analogicus/jnw_gr02_sky130a/sim/JNW_VIS_TI/READMELay.md

TB_NCM

### Transient analysis Schematic (tran)

Check transient operation

|**Name**|**Parameter**|**Description**| |**Min**|**Typ**|**Max**| Unit|
|:---|:---|:---|---:|:---:|:---:|:---:| ---:|
|**Referance Voltage**|**vref27** || **Spec**  | **0.90000** | **1.20000** | **1.50000** | **V** |
| | | |<a href='results/tran_Sch_typical.html'>Sch_typ</a>| | 1.20066 |  | |
| | | |<a href='results/tran_Sch_etc.html'>Sch_etc</a>|1.19779 | 1.20082 | 1.20342 | |
| | | |<a href='results/tran_Sch_mc.html'>Sch_3std</a>|1.07695 | 1.20448 | 1.33201 | |
|**Temperature current**|**i\_temp27** || **Spec**  | **3.00000** | **4.00000** | **5.00000** | **uA** |
| | | |<a href='results/tran_Sch_typical.html'>Sch_typ</a>| | 3.98492 |  | |
| | | |<a href='results/tran_Sch_etc.html'>Sch_etc</a>|3.42394 | 3.97680 | 4.64859 | |
| | | |<a href='results/tran_Sch_mc.html'>Sch_3std</a>|3.07677 | 4.00629 | 4.93581 | |

### Transient analysis Layout (tran_lay)

Check transient operation

|**Name**|**Parameter**|**Description**| |**Min**|**Typ**|**Max**| Unit|
|:---|:---|:---|---:|:---:|:---:|:---:| ---:|
|**Referance Voltage**|**vref27** || **Spec**  | **0.90000** | **1.20000** | **1.50000** | **V** |
| | | |<a href='results/tran_Lay_typical.html'>Lay_typ</a>| | 1.19531 |  | |
| | | |<a href='results/tran_Lay_etc.html'>Lay_etc</a>|1.19195 | 1.19546 | 1.19891 | |
| | | |<a href='results/tran_Lay_mc.html'>Lay_3std</a>|0.99423 | 1.20512 | 1.41601 | |
|**Temperature current**|**i\_temp27** || **Spec**  | **3.00000** | **4.00000** | **5.00000** | **uA** |
| | | |<a href='results/tran_Lay_typical.html'>Lay_typ</a>| | 3.83903 |  | |
| | | |<a href='results/tran_Lay_etc.html'>Lay_etc</a>|3.29571 | 3.83206 | 4.48719 | |
| | | |<a href='results/tran_Lay_mc.html'>Lay_3std</a>|<span style='color:red'>**2.52033**</span> | 3.87374 | <span style='color:red'>**5.22715**</span> | |
