analogicus/jnw_gr02_sky130a/sim/JNW_VIS_TI/summary.md

TB_NCM

### Transient analysis (tran)

Check transient operation

|**Name**|**Parameter**|**Description**| |**Min**|**Typ**|**Max**| Unit|
|:---|:---|:---|---:|:---:|:---:|:---:| ---:|
|**Referance Voltage**|**vref27** || **Spec**  | **0.96000** | **1.20000** | **1.44000** | **V** |
| | | |<a href='results/tran_Sch_typical.html'>Sch_typ</a>| | 1.20077 |  | |
| | | |<a href='results/tran_Sch_etc.html'>Sch_etc</a>|1.19409 | 1.20150 | 1.20996 | |
| | | |<a href='results/tran_Sch_mc.html'>Sch_3std</a>|<span style='color:red'>**0.92611**</span> | 1.26353 | <span style='color:red'>**1.60095**</span> | |
|**Temperature current**|**i\_temp27** || **Spec**  | **1.35000** | **1.80000** | **2.25000** | **uA** |
| | | |<a href='results/tran_Sch_typical.html'>Sch_typ</a>| | 1.89620 |  | |
| | | |<a href='results/tran_Sch_etc.html'>Sch_etc</a>|1.66109 | 1.89896 | 2.20755 | |
| | | |<a href='results/tran_Sch_mc.html'>Sch_3std</a>|<span style='color:red'>**0.82957**</span> | 2.11308 | <span style='color:red'>**3.39658**</span> | |
