analogicus/jnw_gr02_sky130a/rtl/syntesized_design/metrics.csv

Metric | Value
design__lint_error__count | 0
design__lint_timing_construct__count | 0
design__lint_warning__count | 0
design__inferred_latch__count | 0
design__instance__count | 97
design__instance__area | 907.12
design__instance_unmapped__count | 0
synthesis__check_error__count | 0
design__max_slew_violation__count__corner:nom_tt_025C_1v80 | 0
design__max_fanout_violation__count__corner:nom_tt_025C_1v80 | 0
design__max_cap_violation__count__corner:nom_tt_025C_1v80 | 0
power__internal__total | 0.000059762245655292645
power__switching__total | 0.000021324993213056587
power__leakage__total | 1.851219955106842E-9
power__total | 0.00008108908514259383
clock__skew__worst_hold__corner:nom_tt_025C_1v80 | -0.2506414036150417
clock__skew__worst_setup__corner:nom_tt_025C_1v80 | 0.25087249654415317
timing__hold__ws__corner:nom_tt_025C_1v80 | 0.328870384677856
timing__setup__ws__corner:nom_tt_025C_1v80 | 22.779059283579723
timing__hold__tns__corner:nom_tt_025C_1v80 | 0.0
timing__setup__tns__corner:nom_tt_025C_1v80 | 0.0
timing__hold__wns__corner:nom_tt_025C_1v80 | 0
timing__setup__wns__corner:nom_tt_025C_1v80 | 0.0
timing__hold_vio__count__corner:nom_tt_025C_1v80 | 0
timing__hold_r2r__ws__corner:nom_tt_025C_1v80 | 0.328870
timing__hold_r2r_vio__count__corner:nom_tt_025C_1v80 | 0
timing__setup_vio__count__corner:nom_tt_025C_1v80 | 0
timing__setup_r2r__ws__corner:nom_tt_025C_1v80 | Infinity
timing__setup_r2r_vio__count__corner:nom_tt_025C_1v80 | 0
design__max_slew_violation__count__corner:nom_ss_100C_1v60 | 0
design__max_fanout_violation__count__corner:nom_ss_100C_1v60 | 0
design__max_cap_violation__count__corner:nom_ss_100C_1v60 | 0
clock__skew__worst_hold__corner:nom_ss_100C_1v60 | -0.2510860201934031
clock__skew__worst_setup__corner:nom_ss_100C_1v60 | 0.2513045676019815
timing__hold__ws__corner:nom_ss_100C_1v60 | 0.865721796531863
timing__setup__ws__corner:nom_ss_100C_1v60 | 21.58372031083137
timing__hold__tns__corner:nom_ss_100C_1v60 | 0.0
timing__setup__tns__corner:nom_ss_100C_1v60 | 0.0
timing__hold__wns__corner:nom_ss_100C_1v60 | 0
timing__setup__wns__corner:nom_ss_100C_1v60 | 0.0
timing__hold_vio__count__corner:nom_ss_100C_1v60 | 0
timing__hold_r2r__ws__corner:nom_ss_100C_1v60 | 0.865722
timing__hold_r2r_vio__count__corner:nom_ss_100C_1v60 | 0
timing__setup_vio__count__corner:nom_ss_100C_1v60 | 0
timing__setup_r2r__ws__corner:nom_ss_100C_1v60 | Infinity
timing__setup_r2r_vio__count__corner:nom_ss_100C_1v60 | 0
design__max_slew_violation__count__corner:nom_ff_n40C_1v95 | 0
design__max_fanout_violation__count__corner:nom_ff_n40C_1v95 | 0
design__max_cap_violation__count__corner:nom_ff_n40C_1v95 | 0
clock__skew__worst_hold__corner:nom_ff_n40C_1v95 | -0.25056052386541033
clock__skew__worst_setup__corner:nom_ff_n40C_1v95 | 0.2507960021755931
timing__hold__ws__corner:nom_ff_n40C_1v95 | 0.11220624746938532
timing__setup__ws__corner:nom_ff_n40C_1v95 | 23.142537430337665
timing__hold__tns__corner:nom_ff_n40C_1v95 | 0.0
timing__setup__tns__corner:nom_ff_n40C_1v95 | 0.0
timing__hold__wns__corner:nom_ff_n40C_1v95 | 0
timing__setup__wns__corner:nom_ff_n40C_1v95 | 0.0
timing__hold_vio__count__corner:nom_ff_n40C_1v95 | 0
timing__hold_r2r__ws__corner:nom_ff_n40C_1v95 | 0.112206
timing__hold_r2r_vio__count__corner:nom_ff_n40C_1v95 | 0
timing__setup_vio__count__corner:nom_ff_n40C_1v95 | 0
timing__setup_r2r__ws__corner:nom_ff_n40C_1v95 | Infinity
timing__setup_r2r_vio__count__corner:nom_ff_n40C_1v95 | 0
design__max_slew_violation__count | 0
design__max_fanout_violation__count | 0
design__max_cap_violation__count | 0
clock__skew__worst_hold | -0.25042901794442424
clock__skew__worst_setup | 0.2505912770440622
timing__hold__ws | 0.1099763922169367
timing__setup__ws | 21.57810524670322
timing__hold__tns | 0.0
timing__setup__tns | 0.0
timing__hold__wns | 0
timing__setup__wns | 0.0
timing__hold_vio__count | 0
timing__hold_r2r__ws | 0.109976
timing__hold_r2r_vio__count | 0
timing__setup_vio__count | 0
timing__setup_r2r__ws | inf
timing__setup_r2r_vio__count | 0
design__die__bbox | 0.0 0.0 33.0 120.0
design__core__bbox | 5.52 10.88 27.14 108.8
design__io | 12
design__die__area | 3960
design__core__area | 2117.03
design__instance__count__stdcell | 97
design__instance__area__stdcell | 907.12
design__instance__count__macros | 0
design__instance__area__macros | 0
design__instance__utilization | 0.428487
design__instance__utilization__stdcell | 0.428487
design__instance__count__class:inverter | 1
design__instance__count__class:sequential_cell | 17
design__instance__count__class:multi_input_combinational_cell | 30
flow__warnings__count | 1
flow__errors__count | 0
design__instance__count__class:fill_cell | 233
design__instance__count__class:tap_cell | 19
design__power_grid_violation__count__net:VGND | 0
design__power_grid_violation__count__net:VPWR | 0
design__power_grid_violation__count | 0
timing__drv__floating__nets | 0
timing__drv__floating__pins | 0
design__instance__displacement__total | 0
design__instance__displacement__mean | 0
design__instance__displacement__max | 0
route__wirelength__estimated | 1065.7
design__violations | 0
design__instance__count__class:timing_repair_buffer | 26
design__instance__count__class:clock_buffer | 4
design__instance__count__setup_buffer | 0
design__instance__count__hold_buffer | 17
antenna__violating__nets | 0
antenna__violating__pins | 0
route__antenna_violation__count | 0
antenna_diodes_count | 0
route__net | 79
route__net__special | 2
route__drc_errors__iter:1 | 3
route__wirelength__iter:1 | 1158
route__drc_errors__iter:2 | 0
route__wirelength__iter:2 | 1160
route__drc_errors | 0
route__wirelength | 1160
route__vias | 460
route__vias__singlecut | 460
route__vias__multicut | 0
design__disconnected_pin__count | 0
design__critical_disconnected_pin__count | 0
route__wirelength__max | 102.48
timing__unannotated_net__count__corner:nom_tt_025C_1v80 | 1
timing__unannotated_net_filtered__count__corner:nom_tt_025C_1v80 | 0
timing__unannotated_net__count__corner:nom_ss_100C_1v60 | 1
timing__unannotated_net_filtered__count__corner:nom_ss_100C_1v60 | 0
timing__unannotated_net__count__corner:nom_ff_n40C_1v95 | 1
timing__unannotated_net_filtered__count__corner:nom_ff_n40C_1v95 | 0
design__max_slew_violation__count__corner:min_tt_025C_1v80 | 0
design__max_fanout_violation__count__corner:min_tt_025C_1v80 | 0
design__max_cap_violation__count__corner:min_tt_025C_1v80 | 0
clock__skew__worst_hold__corner:min_tt_025C_1v80 | -0.25049066307961
clock__skew__worst_setup__corner:min_tt_025C_1v80 | 0.2506497025323855
timing__hold__ws__corner:min_tt_025C_1v80 | 0.32402326183755903
timing__setup__ws__corner:min_tt_025C_1v80 | 22.780624253999495
timing__hold__tns__corner:min_tt_025C_1v80 | 0.0
timing__setup__tns__corner:min_tt_025C_1v80 | 0.0
timing__hold__wns__corner:min_tt_025C_1v80 | 0
timing__setup__wns__corner:min_tt_025C_1v80 | 0.0
timing__hold_vio__count__corner:min_tt_025C_1v80 | 0
timing__hold_r2r__ws__corner:min_tt_025C_1v80 | 0.324023
timing__hold_r2r_vio__count__corner:min_tt_025C_1v80 | 0
timing__setup_vio__count__corner:min_tt_025C_1v80 | 0
timing__setup_r2r__ws__corner:min_tt_025C_1v80 | Infinity
timing__setup_r2r_vio__count__corner:min_tt_025C_1v80 | 0
timing__unannotated_net__count__corner:min_tt_025C_1v80 | 1
timing__unannotated_net_filtered__count__corner:min_tt_025C_1v80 | 0
design__max_slew_violation__count__corner:min_ss_100C_1v60 | 0
design__max_fanout_violation__count__corner:min_ss_100C_1v60 | 0
design__max_cap_violation__count__corner:min_ss_100C_1v60 | 0
clock__skew__worst_hold__corner:min_ss_100C_1v60 | -0.25089311893741884
clock__skew__worst_setup__corner:min_ss_100C_1v60 | 0.25104338762805173
timing__hold__ws__corner:min_ss_100C_1v60 | 0.8568520024926728
timing__setup__ws__corner:min_ss_100C_1v60 | 21.58726236646931
timing__hold__tns__corner:min_ss_100C_1v60 | 0.0
timing__setup__tns__corner:min_ss_100C_1v60 | 0.0
timing__hold__wns__corner:min_ss_100C_1v60 | 0
timing__setup__wns__corner:min_ss_100C_1v60 | 0.0
timing__hold_vio__count__corner:min_ss_100C_1v60 | 0
timing__hold_r2r__ws__corner:min_ss_100C_1v60 | 0.856852
timing__hold_r2r_vio__count__corner:min_ss_100C_1v60 | 0
timing__setup_vio__count__corner:min_ss_100C_1v60 | 0
timing__setup_r2r__ws__corner:min_ss_100C_1v60 | Infinity
timing__setup_r2r_vio__count__corner:min_ss_100C_1v60 | 0
timing__unannotated_net__count__corner:min_ss_100C_1v60 | 1
timing__unannotated_net_filtered__count__corner:min_ss_100C_1v60 | 0
design__max_slew_violation__count__corner:min_ff_n40C_1v95 | 0
design__max_fanout_violation__count__corner:min_ff_n40C_1v95 | 0
design__max_cap_violation__count__corner:min_ff_n40C_1v95 | 0
clock__skew__worst_hold__corner:min_ff_n40C_1v95 | -0.25042901794442424
clock__skew__worst_setup__corner:min_ff_n40C_1v95 | 0.2505912770440622
timing__hold__ws__corner:min_ff_n40C_1v95 | 0.1099763922169367
timing__setup__ws__corner:min_ff_n40C_1v95 | 23.14379509101553
timing__hold__tns__corner:min_ff_n40C_1v95 | 0.0
timing__setup__tns__corner:min_ff_n40C_1v95 | 0.0
timing__hold__wns__corner:min_ff_n40C_1v95 | 0
timing__setup__wns__corner:min_ff_n40C_1v95 | 0.0
timing__hold_vio__count__corner:min_ff_n40C_1v95 | 0
timing__hold_r2r__ws__corner:min_ff_n40C_1v95 | 0.109976
timing__hold_r2r_vio__count__corner:min_ff_n40C_1v95 | 0
timing__setup_vio__count__corner:min_ff_n40C_1v95 | 0
timing__setup_r2r__ws__corner:min_ff_n40C_1v95 | Infinity
timing__setup_r2r_vio__count__corner:min_ff_n40C_1v95 | 0
timing__unannotated_net__count__corner:min_ff_n40C_1v95 | 1
timing__unannotated_net_filtered__count__corner:min_ff_n40C_1v95 | 0
design__max_slew_violation__count__corner:max_tt_025C_1v80 | 0
design__max_fanout_violation__count__corner:max_tt_025C_1v80 | 0
design__max_cap_violation__count__corner:max_tt_025C_1v80 | 0
clock__skew__worst_hold__corner:max_tt_025C_1v80 | -0.2509011402989986
clock__skew__worst_setup__corner:max_tt_025C_1v80 | 0.2511445011928792
timing__hold__ws__corner:max_tt_025C_1v80 | 0.334382420106406
timing__setup__ws__corner:max_tt_025C_1v80 | 22.776494224231083
timing__hold__tns__corner:max_tt_025C_1v80 | 0.0
timing__setup__tns__corner:max_tt_025C_1v80 | 0.0
timing__hold__wns__corner:max_tt_025C_1v80 | 0
timing__setup__wns__corner:max_tt_025C_1v80 | 0.0
timing__hold_vio__count__corner:max_tt_025C_1v80 | 0
timing__hold_r2r__ws__corner:max_tt_025C_1v80 | 0.334382
timing__hold_r2r_vio__count__corner:max_tt_025C_1v80 | 0
timing__setup_vio__count__corner:max_tt_025C_1v80 | 0
timing__setup_r2r__ws__corner:max_tt_025C_1v80 | Infinity
timing__setup_r2r_vio__count__corner:max_tt_025C_1v80 | 0
timing__unannotated_net__count__corner:max_tt_025C_1v80 | 1
timing__unannotated_net_filtered__count__corner:max_tt_025C_1v80 | 0
design__max_slew_violation__count__corner:max_ss_100C_1v60 | 0
design__max_fanout_violation__count__corner:max_ss_100C_1v60 | 0
design__max_cap_violation__count__corner:max_ss_100C_1v60 | 0
clock__skew__worst_hold__corner:max_ss_100C_1v60 | -0.2509557355177786
clock__skew__worst_setup__corner:max_ss_100C_1v60 | 0.2513913870449626
timing__hold__ws__corner:max_ss_100C_1v60 | 0.8758818918067648
timing__setup__ws__corner:max_ss_100C_1v60 | 21.57810524670322
timing__hold__tns__corner:max_ss_100C_1v60 | 0.0
timing__setup__tns__corner:max_ss_100C_1v60 | 0.0
timing__hold__wns__corner:max_ss_100C_1v60 | 0
timing__setup__wns__corner:max_ss_100C_1v60 | 0.0
timing__hold_vio__count__corner:max_ss_100C_1v60 | 0
timing__hold_r2r__ws__corner:max_ss_100C_1v60 | 0.875882
timing__hold_r2r_vio__count__corner:max_ss_100C_1v60 | 0
timing__setup_vio__count__corner:max_ss_100C_1v60 | 0
timing__setup_r2r__ws__corner:max_ss_100C_1v60 | Infinity
timing__setup_r2r_vio__count__corner:max_ss_100C_1v60 | 0
timing__unannotated_net__count__corner:max_ss_100C_1v60 | 1
timing__unannotated_net_filtered__count__corner:max_ss_100C_1v60 | 0
design__max_slew_violation__count__corner:max_ff_n40C_1v95 | 0
design__max_fanout_violation__count__corner:max_ff_n40C_1v95 | 0
design__max_cap_violation__count__corner:max_ff_n40C_1v95 | 0
clock__skew__worst_hold__corner:max_ff_n40C_1v95 | -0.2509152401318101
clock__skew__worst_setup__corner:max_ff_n40C_1v95 | 0.2510895173960295
timing__hold__ws__corner:max_ff_n40C_1v95 | 0.11440018700597156
timing__setup__ws__corner:max_ff_n40C_1v95 | 23.141214044454884
timing__hold__tns__corner:max_ff_n40C_1v95 | 0.0
timing__setup__tns__corner:max_ff_n40C_1v95 | 0.0
timing__hold__wns__corner:max_ff_n40C_1v95 | 0
timing__setup__wns__corner:max_ff_n40C_1v95 | 0.0
timing__hold_vio__count__corner:max_ff_n40C_1v95 | 0
timing__hold_r2r__ws__corner:max_ff_n40C_1v95 | 0.114400
timing__hold_r2r_vio__count__corner:max_ff_n40C_1v95 | 0
timing__setup_vio__count__corner:max_ff_n40C_1v95 | 0
timing__setup_r2r__ws__corner:max_ff_n40C_1v95 | Infinity
timing__setup_r2r_vio__count__corner:max_ff_n40C_1v95 | 0
timing__unannotated_net__count__corner:max_ff_n40C_1v95 | 1
timing__unannotated_net_filtered__count__corner:max_ff_n40C_1v95 | 0
timing__unannotated_net__count | 1
timing__unannotated_net_filtered__count | 0
design_powergrid__voltage__worst__net:VPWR__corner:nom_tt_025C_1v80 | 1.79998
design_powergrid__drop__average__net:VPWR__corner:nom_tt_025C_1v80 | 1.8
design_powergrid__drop__worst__net:VPWR__corner:nom_tt_025C_1v80 | 0.0000245472
design_powergrid__voltage__worst__net:VGND__corner:nom_tt_025C_1v80 | 0.0000308588
design_powergrid__drop__average__net:VGND__corner:nom_tt_025C_1v80 | 0.00000547415
design_powergrid__drop__worst__net:VGND__corner:nom_tt_025C_1v80 | 0.0000308588
design_powergrid__voltage__worst | 0.0000308588
design_powergrid__voltage__worst__net:VPWR | 1.79998
design_powergrid__drop__worst | 0.0000308588
design_powergrid__drop__worst__net:VPWR | 0.0000245472
design_powergrid__voltage__worst__net:VGND | 0.0000308588
design_powergrid__drop__worst__net:VGND | 0.0000308588
ir__voltage__worst | 1.8000000000000000444089209850062616169452667236328125
ir__drop__avg | 0.000004950000000000000040700949555105836452639778144657611846923828125
ir__drop__worst | 0.00002449999999999999920896609495457596494816243648529052734375
design__xor_difference__count | 0
magic__drc_error__count | 0
klayout__drc_error__count | 0
magic__illegal_overlap__count | 0
design__lvs_device_difference__count | 0
design__lvs_net_difference__count | 0
design__lvs_property_fail__count | 0
design__lvs_error__count | 0
design__lvs_unmatched_device__count | 0
design__lvs_unmatched_net__count | 0
design__lvs_unmatched_pin__count | 0
