analogicus/jnw_gr02_sky130a/Figures/AIC_TI_LaySch_Single.png

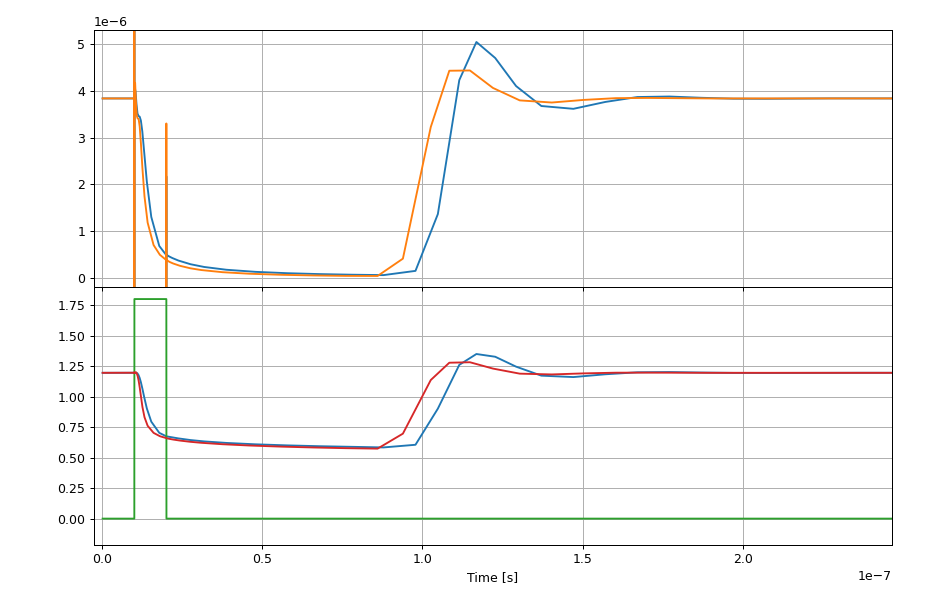
Figures/AIC_TI_LaySch_Single.png
