analogicus/jnw_gr02_sky130a/sim/JNW_GR02_VIS/SensorFunction_combined.png

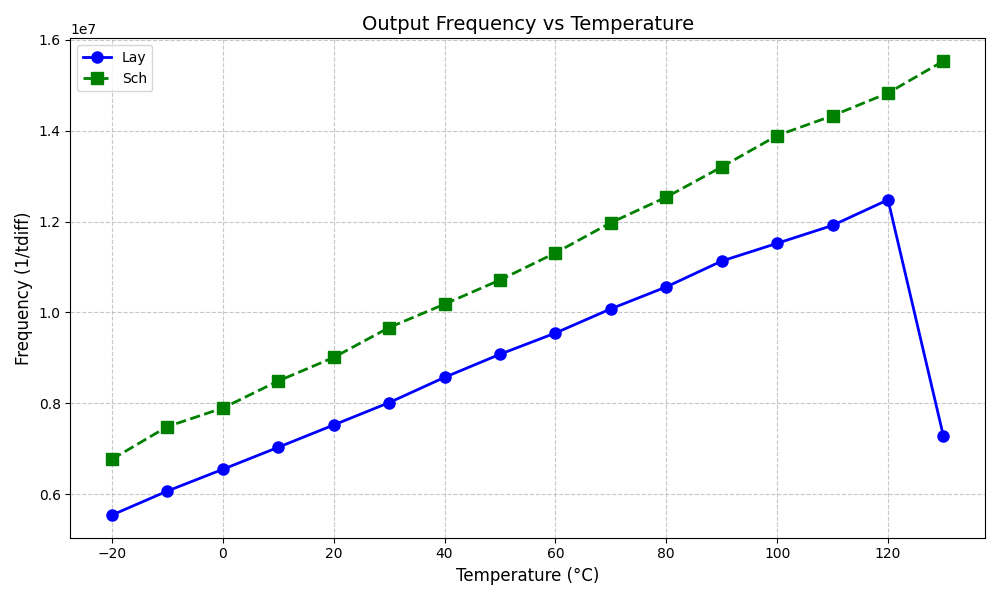
sim/JNW_GR02_VIS/SensorFunction_combined.png
