analogicus/jnw_gr02_sky130a/sim/JNW_GR02_VIS/SensorFunction_Lay2.png

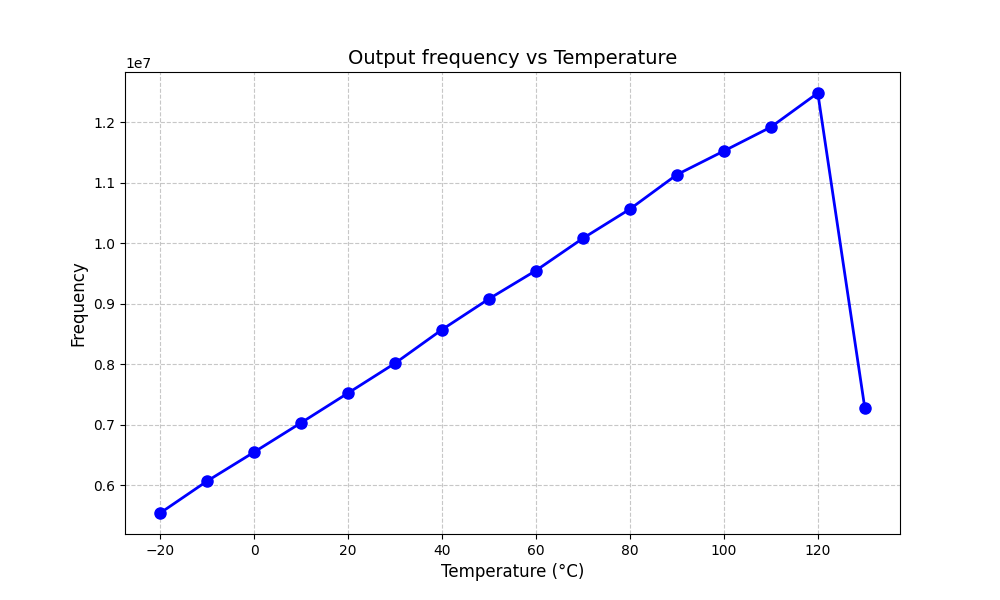
sim/JNW_GR02_VIS/SensorFunction_Lay2.png
