analogicus/jnw_gr02_sky130a/sim/JNW_VIS_TI/AIC_CurrentMeasurmentUnstability.png

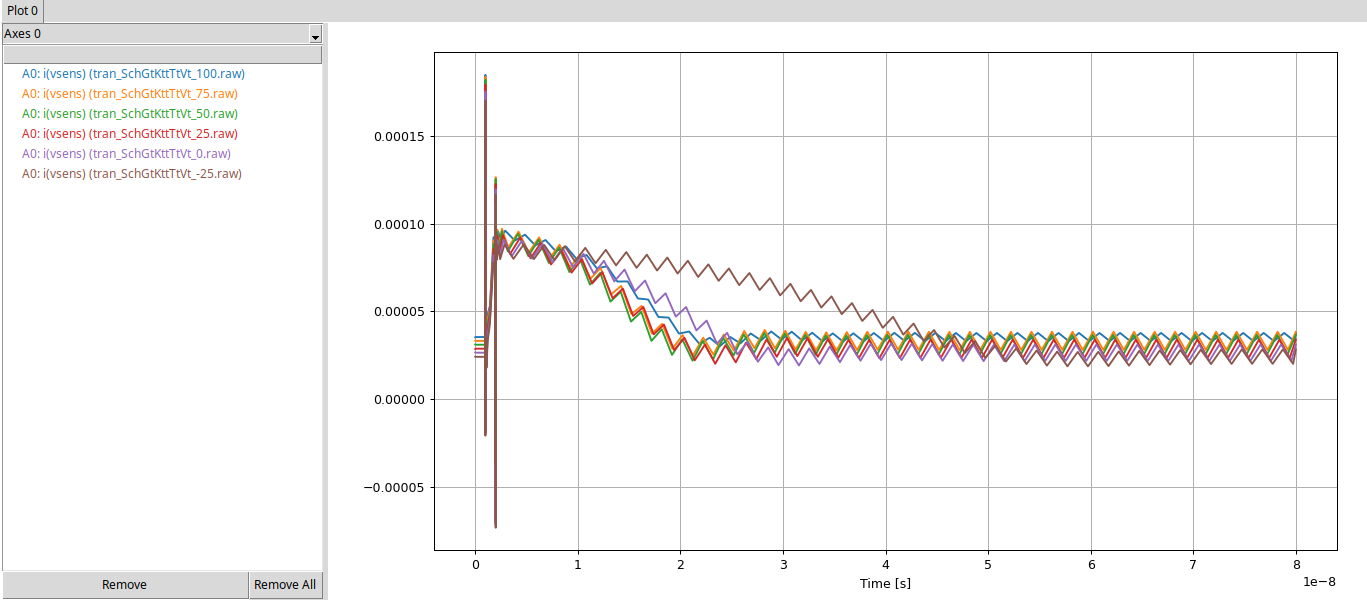
sim/JNW_VIS_TI/AIC_CurrentMeasurmentUnstability.png
