analogicus/jnw_gr02_sky130a/sim/JNW_VIS_TI/Figure_1_GoodLinearity.png

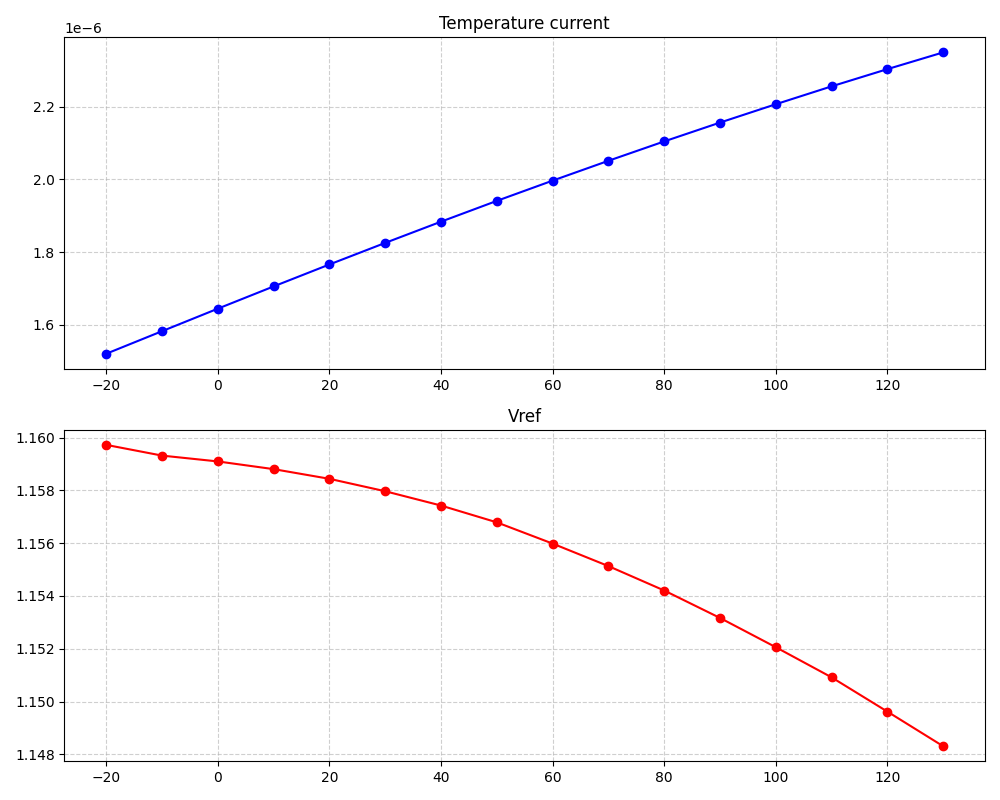
sim/JNW_VIS_TI/Figure_1_GoodLinearity.png
