analogicus/jnw_gr02_sky130a/sim/JNW_VIS_TI/Figures/combined_Lay_Sch.png

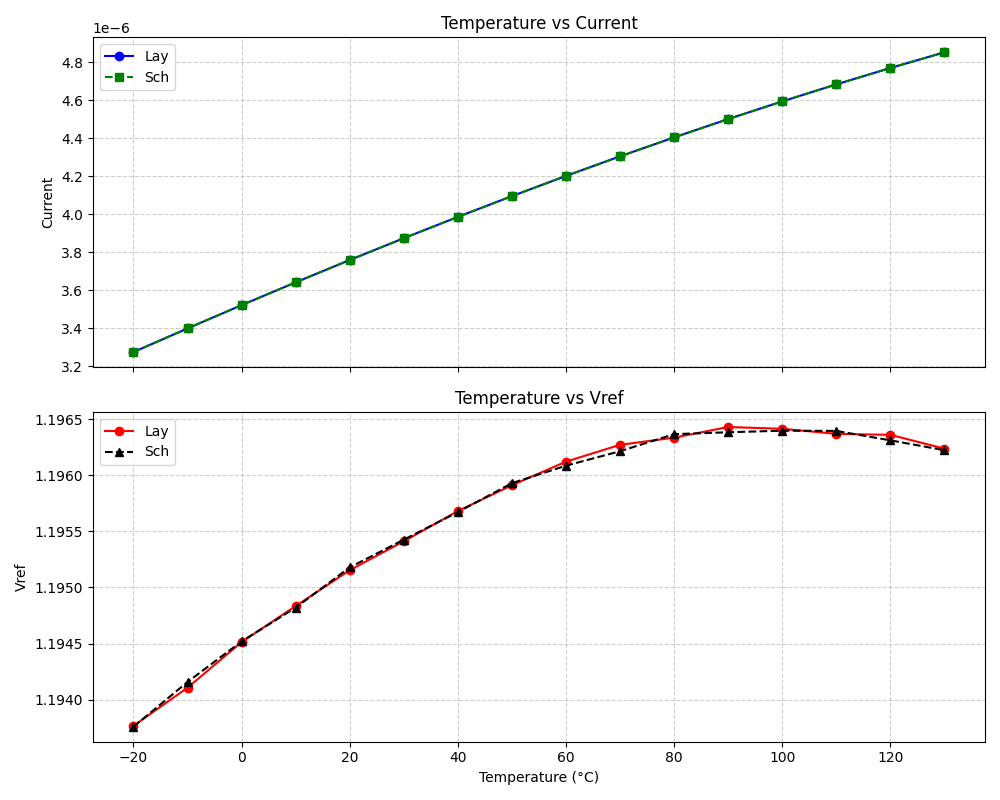
sim/JNW_VIS_TI/Figures/combined_Lay_Sch.png
