analogicus/jnw_gr02_sky130a/sim/JNW_VIS_TI/isens_dc_plot.png

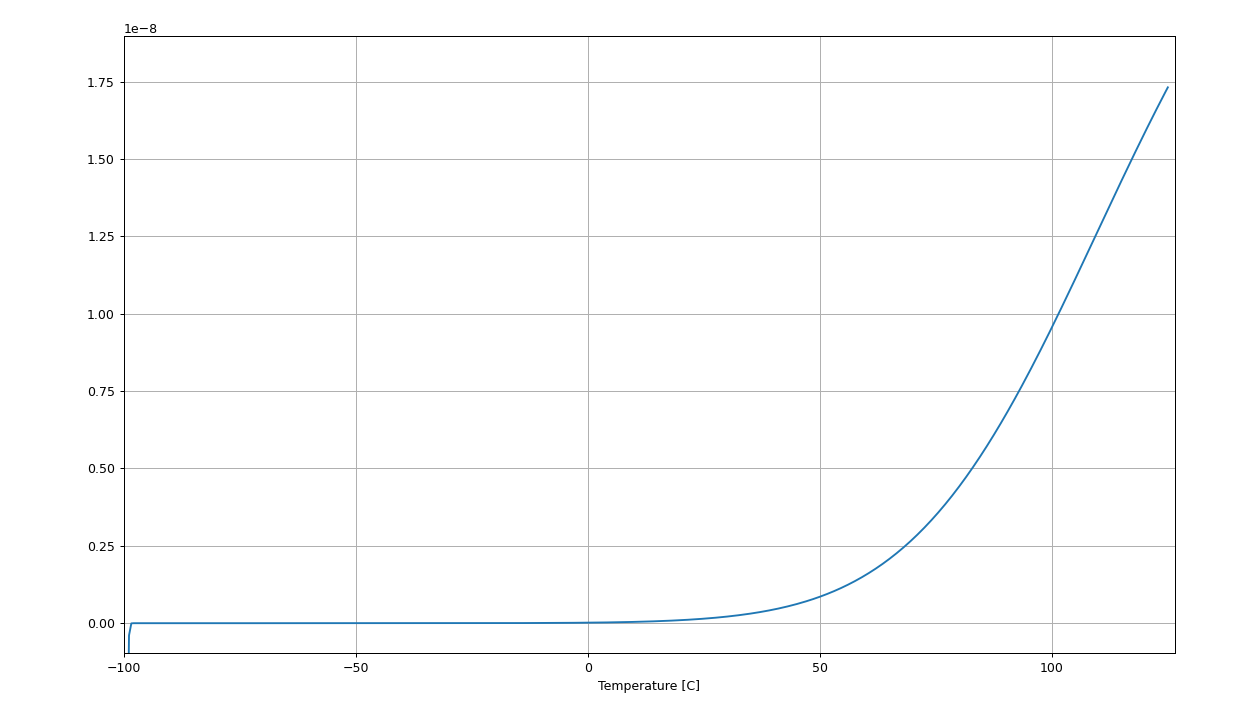
sim/JNW_VIS_TI/isens_dc_plot.png
