analogicus/jnw_gr02_sky130a/sim/JNW_VIS_TI/vref_dc_plot.png

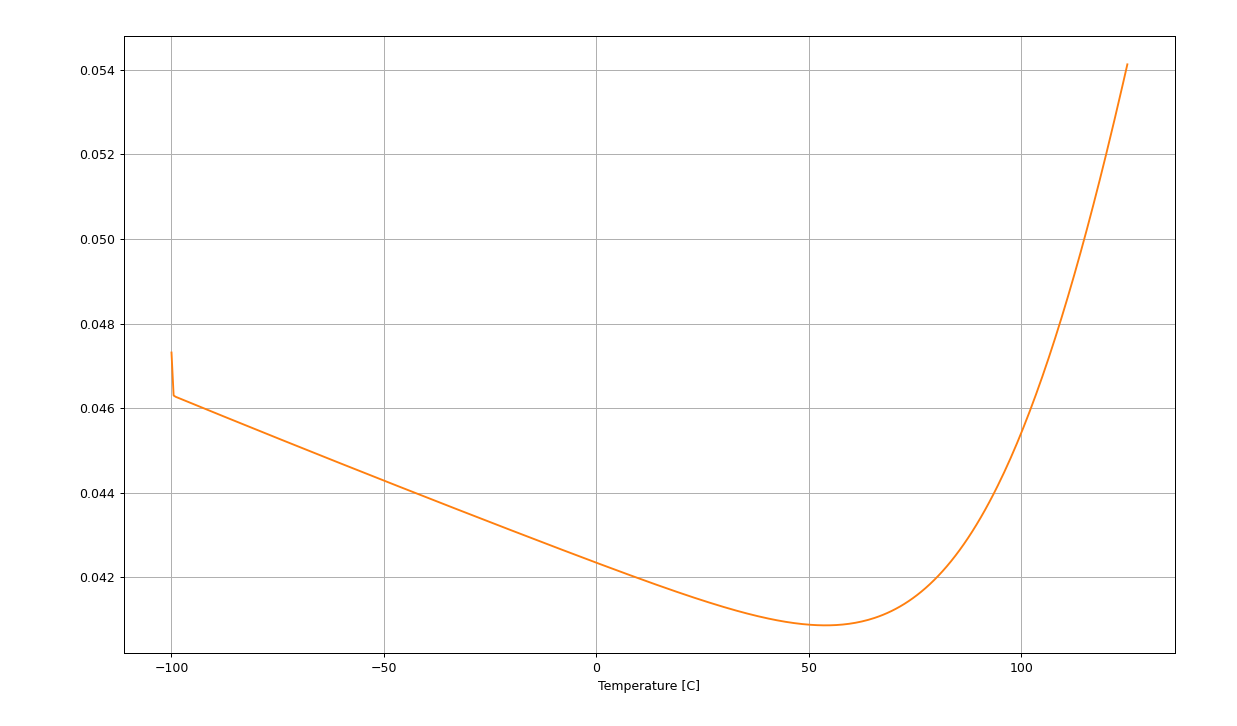
sim/JNW_VIS_TI/vref_dc_plot.png
