analogicus/jnw_gr02_sky130a/sim/JNW_VIS_TI/results/tran_Lay_mc.md

### Summary tran_Lay_mc

For details see <a href='tran_Lay_mc.html'>tran_Lay_mc.html</a>

|**Name**|**Parameter**|**View**|**Min** | **Typ** | **Max**|
|:---|:---|:---:|:---:|:---:|:---:|
|Referance Voltage|vref27 | Spec | 0.90000 V | 1.20000 V | 1.50000 V |
| | | ('Lay',)|1.09201 V | 1.19817 V | 1.30001 V |
|Temperature current|i\_temp27 | Spec | 3.00000 uA | 4.00000 uA | 5.00000 uA |
| | | ('Lay',)|3.02029 uA | 3.88591 uA | 4.44162 uA |
