analogicus/jnw_gr02_sky130a/sim/JNW_VIS_TI/results/tran_Lay_etc.md

### Summary tran_Lay_etc

For details see <a href='tran_Lay_etc.html'>tran_Lay_etc.html</a>

|**Name**|**Parameter**|**View**|**Min** | **Typ** | **Max**|
|:---|:---|:---:|:---:|:---:|:---:|
|Referance Voltage|vref27 | Spec | 0.90000 V | 1.20000 V | 1.50000 V |
| | | ('Lay',)|1.19194 V | 1.19546 V | 1.19891 V |
|Temperature current|i\_temp27 | Spec | 3.00000 uA | 4.00000 uA | 5.00000 uA |
| | | ('Lay',)|3.29567 uA | 3.83206 uA | 4.48719 uA |
