analogicus/jnw_gr02_sky130a/sim/JNW_VIS_TI/results/tran_Sch_etc.md

### Summary tran_Sch_etc

For details see <a href='tran_Sch_etc.html'>tran_Sch_etc.html</a>

|**Name**|**Parameter**|**View**|**Min** | **Typ** | **Max**|
|:---|:---|:---:|:---:|:---:|:---:|
|Referance Voltage|vref27 | Spec | 0.93000 V | 1.24000 V | 1.55000 V |
| | | ('Sch',)|1.19779 V | 1.20082 V | 1.20342 V |
|Temperature current|i\_temp27 | Spec | 2.85000 uA | 3.80000 uA | 4.75000 uA |
| | | ('Sch',)|3.42395 uA | 3.97680 uA | 4.64859 uA |
