analogicus/jnw_gr02_sky130a/sim/JNW_VIS_TI/results/tran_Sch_mc.md

### Summary tran_Sch_mc

For details see <a href='tran_Sch_mc.html'>tran_Sch_mc.html</a>

|**Name**|**Parameter**|**View**|**Min** | **Typ** | **Max**|
|:---|:---|:---:|:---:|:---:|:---:|
|Referance Voltage|vref27 | Spec | 0.93000 V | 1.24000 V | 1.55000 V |
| | | ('Sch',)|1.13223 V | 1.20292 V | 1.29165 V |
|Temperature current|i\_temp27 | Spec | 2.85000 uA | 3.80000 uA | 4.75000 uA |
| | | ('Sch',)|3.47029 uA | 3.98931 uA | 4.59820 uA |
