analogicus/jnw_gr02_sky130a/sim/JNW_VIS_OTA/results/tran_Lay_etc.md

### Summary tran_Lay_etc

For details see <a href='tran_Lay_etc.html'>tran_Lay_etc.html</a>

|**Name**|**Parameter**|**View**|**Min** | **Typ** | **Max**|
|:---|:---|:---:|:---:|:---:|:---:|
||offset | Spec | -50.000 mV |  | 50.000 mV |
| | | ('Lay',)|-0.978 mV | 0.880 mV | 3.383 mV |
