analogicus/jnw_gr02_sky130a/sim/JNW_VIS_OTA/results/tran_Lay_mc.md

### Summary tran_Lay_mc

For details see <a href='tran_Lay_mc.html'>tran_Lay_mc.html</a>

|**Name**|**Parameter**|**View**|**Min** | **Typ** | **Max**|
|:---|:---|:---:|:---:|:---:|:---:|
||offset | Spec | -50.000 mV |  | 50.000 mV |
| | | ('Lay',)|-13.254 mV | 0.570 mV | 11.029 mV |
