analogicus/jnw_gr02_sky130a/sim/JNW_VIS_OTA/results/tran_Sch_mc.md

### Summary tran_Sch_mc

For details see <a href='tran_Sch_mc.html'>tran_Sch_mc.html</a>

|**Name**|**Parameter**|**View**|**Min** | **Typ** | **Max**|
|:---|:---|:---:|:---:|:---:|:---:|
||offset | Spec | -50.000 mV |  | 50.000 mV |
| | | ('Sch',)|-9.331 mV | 1.352 mV | 10.781 mV |
