analogicus/jnw_gr02_sky130a/sim/JNW_VIS_OTA/results/tran_Sch_typical.md

### Summary tran_Sch_typical

For details see <a href='tran_Sch_typical.html'>tran_Sch_typical.html</a>

|**Name**|**Parameter**|**View**|**Min** | **Typ** | **Max**|
|:---|:---|:---:|:---:|:---:|:---:|
||offset | Spec | -50.000 mV |  | 50.000 mV |
| | | ('Sch',)|0.772 mV | 0.772 mV | 0.772 mV |
