analogicus/jnw_gr02_sky130a/sim/JNW_VIS_OTA/results/tran_Lay_typical.csv

 | offset | name | type | time | OK
0 | 0.7717552 | tran_LayGtKttTtVt | Lay | Mon Apr 28 21:26:37 2025 | True
