analogicus/jnw_gr02_sky130a/sim/JNW_VIS_OTA/results/tran_Sch_typical.csv

 | offset | name | type | time | OK
0 | 0.7717529 | tran_SchGtKttTtVt | Sch | Thu Apr 24 11:40:22 2025 | True
