analogicus/jnw_gr02_sky130a/design/JNW_GR02_SKY130A/simulation/TEMP_CURR_AK_SYM.spice

** sch_path: /home/athanas/pro/aicex/ip/jnw_gr02_sky130a/design/JNW_GR02_SKY130A/TEMP_CURR_AK_SYM.sch
**.subckt TEMP_CURR_AK_SYM VDD PWR_UP VSS VREF I_TEMP LPO LPI
*.ipin VDD
*.ipin PWR_UP
*.ipin VSS
*.opin VREF
*.opin I_TEMP
*.opin LPO
*.opin LPI
x1 VDD VREF LPO LPI PWR_UP I_TEMP VSS TEMP_CURR_AK
**** begin user architecture code



.param mc_mm_switch=0
.param mc_pr_switch=0
.include tt.spi
*.include ss.spi
.option gmin=1e-15
.lib ../../../tech/ngspice/temperature.spi Tl
.lib ../../../tech/ngspice/supply.spi Vl
.include ../../../../cpdk/ngspice/ideal_circuits.spi
.include ~/pro/aicex/ip/cpdk/ngspice/tian_subckt.lib

X999 LPI LPO loopgainprobe

VSS  VSS  0     dc 0
VDD  VDD VSS dc 1.8
VPUP PWR_UP VSS PULSE ( 0 1.8 1NS 1PS 1PS 1NS 1S 1)
VSENS I_TEMP 0 dc 0.5
.option temp = 25
.option savecurrents
.save all
.control


optran 0 0 0 10n 10u 0
op
write TEMP_CURR_AK_SYM.raw
exit
.endc
.end



**** end user architecture code
**.ends

* expanding   symbol:  JNW_GR02_SKY130A/TEMP_CURR_AK.sym # of pins=7
** sym_path: /home/athanas/pro/aicex/ip/jnw_gr02_sky130a/design/JNW_GR02_SKY130A/TEMP_CURR_AK.sym
** sch_path: /home/athanas/pro/aicex/ip/jnw_gr02_sky130a/design/JNW_GR02_SKY130A/TEMP_CURR_AK.sch
.subckt TEMP_CURR_AK VDD LPO VREF I_TEMP PWR_UP LPI VSS
*.opin LPO
*.opin I_TEMP
*.opin VREF
*.ipin VDD
*.ipin VSS
*.ipin PWR_UP
*.opin LPI
x1 VDD VD1 VD1P LPO VSS OPAMP_AK
XQ1 VSS VSS VD1 sky130_fd_pr__pnp_05v5_W3p40L3p40 m=1 mult=1
XQ2 VSS VSS net1 sky130_fd_pr__pnp_05v5_W3p40L3p40 m=8 mult=8
x2<0> net1 VD1P VSS JNWTR_RPPO4
x2<1> net1 VD1P VSS JNWTR_RPPO4
x2<2> net1 VD1P VSS JNWTR_RPPO4
x2<3> net1 VD1P VSS JNWTR_RPPO4
x2<4> net1 VD1P VSS JNWTR_RPPO4
x2<5> net1 VD1P VSS JNWTR_RPPO4
x1<0> VD1P VREF VSS JNWTR_RPPO8
x1<1> VD1P VREF VSS JNWTR_RPPO8
x2 VREF net2 VDD VDD JNWATR_PCH_8C1F2
x3 VD1 net2 VDD VDD JNWATR_PCH_8C1F2
x4 I_TEMP net2 VDD VDD JNWATR_PCH_8C1F2
x5 net2 net2 VDD VDD JNWATR_PCH_8C1F2
x6 net2 LPI VSS VSS JNWATR_NCH_8C5F0
x7 VDD PWR_UP LPI VSS JNWATR_NCH_12C1F2
x8<0> LPI VSS JNWTR_CAPX1
.ends


* expanding   symbol:  JNW_GR02_SKY130A/OPAMP_AK.sym # of pins=5
** sym_path: /home/athanas/pro/aicex/ip/jnw_gr02_sky130a/design/JNW_GR02_SKY130A/OPAMP_AK.sym
** sch_path: /home/athanas/pro/aicex/ip/jnw_gr02_sky130a/design/JNW_GR02_SKY130A/OPAMP_AK.sch
.subckt OPAMP_AK VDD VD1 VD1P VOUT VSS
*.ipin VDD
*.ipin VD1P
*.ipin VD1
*.ipin VSS
*.opin VOUT
x1 net1 net1 VDD VDD JNWATR_PCH_8C1F2
x2 net3 net1 VDD VDD JNWATR_PCH_8C1F2
x3<0> net2 net1 VSS JNWTR_RPPO2
x3<1> net2 net1 VSS JNWTR_RPPO2
x4 VSS net2 VSS JNWTR_RPPO4
x5 net4 VD1P net3 net3 JNWATR_PCH_4C1F2
x6 net5 VD1 net3 net3 JNWATR_PCH_4C1F2
x7 net4 net4 VSS VSS JNWATR_NCH_4C5F0
x8 net5 net5 VSS VSS JNWATR_NCH_4C5F0
x9 VOUT net5 VSS VSS JNWATR_NCH_4C5F0
x10 net6 net4 VSS VSS JNWATR_NCH_4C5F0
x3 net6 net6 VDD net7 JNWATR_PCH_8C1F2
x11 VOUT net6 VDD VDD JNWATR_PCH_8C1F2
.ends


* expanding   symbol:  JNW_TR_SKY130A/JNWTR_RPPO4.sym # of pins=3
** sym_path: /home/athanas/pro/aicex/ip/jnw_gr02_sky130a/design/JNW_TR_SKY130A/JNWTR_RPPO4.sym
** sch_path: /home/athanas/pro/aicex/ip/jnw_gr02_sky130a/design/JNW_TR_SKY130A/JNWTR_RPPO4.sch
.subckt JNWTR_RPPO4 N P B
*.iopin P
*.iopin N
*.iopin B
XXA1 N P B JNWTR_RES4
.ends


* expanding   symbol:  JNW_TR_SKY130A/JNWTR_RPPO8.sym # of pins=3
** sym_path: /home/athanas/pro/aicex/ip/jnw_gr02_sky130a/design/JNW_TR_SKY130A/JNWTR_RPPO8.sym
** sch_path: /home/athanas/pro/aicex/ip/jnw_gr02_sky130a/design/JNW_TR_SKY130A/JNWTR_RPPO8.sch
.subckt JNWTR_RPPO8 N P B
*.iopin P
*.iopin N
*.iopin B
XXA1 N P B JNWTR_RES8
.ends


* expanding   symbol:  JNW_ATR_SKY130A/JNWATR_PCH_8C1F2.sym # of pins=4
** sym_path: /home/athanas/pro/aicex/ip/jnw_gr02_sky130a/design/JNW_ATR_SKY130A/JNWATR_PCH_8C1F2.sym
** sch_path: /home/athanas/pro/aicex/ip/jnw_gr02_sky130a/design/JNW_ATR_SKY130A/JNWATR_PCH_8C1F2.sch
.subckt JNWATR_PCH_8C1F2 D G S B
*.iopin D
*.iopin G
*.iopin S
*.iopin B
XM1 D G S B sky130_fd_pr__pfet_01v8 L=0.22 W=5.76 nf=2 ad='int((nf+1)/2) * W/nf * 0.29' as='int((nf+2)/2) * W/nf * 0.29' pd='2*int((nf+1)/2) * (W/nf + 0.29)'
+ ps='2*int((nf+2)/2) * (W/nf + 0.29)' nrd='0.29 / W' nrs='0.29 / W' sa=0 sb=0 sd=0 mult=1 m=1
.ends


* expanding   symbol:  JNW_ATR_SKY130A/JNWATR_NCH_8C5F0.sym # of pins=4
** sym_path: /home/athanas/pro/aicex/ip/jnw_gr02_sky130a/design/JNW_ATR_SKY130A/JNWATR_NCH_8C5F0.sym
** sch_path: /home/athanas/pro/aicex/ip/jnw_gr02_sky130a/design/JNW_ATR_SKY130A/JNWATR_NCH_8C5F0.sch
.subckt JNWATR_NCH_8C5F0 D G S B
*.iopin D
*.iopin G
*.iopin S
*.iopin B
XM1 D G S B sky130_fd_pr__nfet_01v8 L=0.94 W=5.76 nf=2 ad='int((nf+1)/2) * W/nf * 0.29' as='int((nf+2)/2) * W/nf * 0.29' pd='2*int((nf+1)/2) * (W/nf + 0.29)'
+ ps='2*int((nf+2)/2) * (W/nf + 0.29)' nrd='0.29 / W' nrs='0.29 / W' sa=0 sb=0 sd=0 mult=1 m=1
.ends


* expanding   symbol:  JNW_ATR_SKY130A/JNWATR_NCH_12C1F2.sym # of pins=4
** sym_path: /home/athanas/pro/aicex/ip/jnw_gr02_sky130a/design/JNW_ATR_SKY130A/JNWATR_NCH_12C1F2.sym
** sch_path: /home/athanas/pro/aicex/ip/jnw_gr02_sky130a/design/JNW_ATR_SKY130A/JNWATR_NCH_12C1F2.sch
.subckt JNWATR_NCH_12C1F2 D G S B
*.iopin D
*.iopin G
*.iopin S
*.iopin B
XM1 D G S B sky130_fd_pr__nfet_01v8 L=0.22 W=8.32 nf=2 ad='int((nf+1)/2) * W/nf * 0.29' as='int((nf+2)/2) * W/nf * 0.29' pd='2*int((nf+1)/2) * (W/nf + 0.29)'
+ ps='2*int((nf+2)/2) * (W/nf + 0.29)' nrd='0.29 / W' nrs='0.29 / W' sa=0 sb=0 sd=0 mult=1 m=1
.ends


* expanding   symbol:  JNW_TR_SKY130A/JNWTR_CAPX1.sym # of pins=2
** sym_path: /home/athanas/pro/aicex/ip/jnw_gr02_sky130a/design/JNW_TR_SKY130A/JNWTR_CAPX1.sym
** sch_path: /home/athanas/pro/aicex/ip/jnw_gr02_sky130a/design/JNW_TR_SKY130A/JNWTR_CAPX1.sch
.subckt JNWTR_CAPX1 A B
*.iopin A
*.iopin B
XC1 B A sky130_fd_pr__cap_mim_m3_1 W=5 L=5 MF=1 m=1
.ends


* expanding   symbol:  JNW_TR_SKY130A/JNWTR_RPPO2.sym # of pins=3
** sym_path: /home/athanas/pro/aicex/ip/jnw_gr02_sky130a/design/JNW_TR_SKY130A/JNWTR_RPPO2.sym
** sch_path: /home/athanas/pro/aicex/ip/jnw_gr02_sky130a/design/JNW_TR_SKY130A/JNWTR_RPPO2.sch
.subckt JNWTR_RPPO2 N P B
*.iopin P
*.iopin N
*.iopin B
XXA1 N P B JNWTR_RES2
.ends


* expanding   symbol:  JNW_ATR_SKY130A/JNWATR_PCH_4C1F2.sym # of pins=4
** sym_path: /home/athanas/pro/aicex/ip/jnw_gr02_sky130a/design/JNW_ATR_SKY130A/JNWATR_PCH_4C1F2.sym
** sch_path: /home/athanas/pro/aicex/ip/jnw_gr02_sky130a/design/JNW_ATR_SKY130A/JNWATR_PCH_4C1F2.sch
.subckt JNWATR_PCH_4C1F2 D G S B
*.iopin D
*.iopin G
*.iopin S
*.iopin B
XM1 D G S B sky130_fd_pr__pfet_01v8 L=0.22 W=3.2 nf=2 ad='int((nf+1)/2) * W/nf * 0.29' as='int((nf+2)/2) * W/nf * 0.29' pd='2*int((nf+1)/2) * (W/nf + 0.29)'
+ ps='2*int((nf+2)/2) * (W/nf + 0.29)' nrd='0.29 / W' nrs='0.29 / W' sa=0 sb=0 sd=0 mult=1 m=1
.ends


* expanding   symbol:  JNW_ATR_SKY130A/JNWATR_NCH_4C5F0.sym # of pins=4
** sym_path: /home/athanas/pro/aicex/ip/jnw_gr02_sky130a/design/JNW_ATR_SKY130A/JNWATR_NCH_4C5F0.sym
** sch_path: /home/athanas/pro/aicex/ip/jnw_gr02_sky130a/design/JNW_ATR_SKY130A/JNWATR_NCH_4C5F0.sch
.subckt JNWATR_NCH_4C5F0 D G S B
*.iopin D
*.iopin G
*.iopin S
*.iopin B
XM1 D G S B sky130_fd_pr__nfet_01v8 L=0.94 W=3.2 nf=2 ad='int((nf+1)/2) * W/nf * 0.29' as='int((nf+2)/2) * W/nf * 0.29' pd='2*int((nf+1)/2) * (W/nf + 0.29)'
+ ps='2*int((nf+2)/2) * (W/nf + 0.29)' nrd='0.29 / W' nrs='0.29 / W' sa=0 sb=0 sd=0 mult=1 m=1
.ends


* expanding   symbol:  JNW_TR_SKY130A/JNWTR_RES4.sym # of pins=3
** sym_path: /home/athanas/pro/aicex/ip/jnw_gr02_sky130a/design/JNW_TR_SKY130A/JNWTR_RES4.sym
** sch_path: /home/athanas/pro/aicex/ip/jnw_gr02_sky130a/design/JNW_TR_SKY130A/JNWTR_RES4.sch
.subckt JNWTR_RES4 N P B
*.iopin N
*.iopin P
*.iopin B
XR1_0 INT_0 N B sky130_fd_pr__res_high_po W=0.36 L=7.36 mult=1 m=1
XR1_1 INT_1 INT_0 B sky130_fd_pr__res_high_po W=0.36 L=7.36 mult=1 m=1
XR1_2 INT_2 INT_1 B sky130_fd_pr__res_high_po W=0.36 L=7.36 mult=1 m=1
XR1_3 P INT_2 B sky130_fd_pr__res_high_po W=0.36 L=7.36 mult=1 m=1
.ends


* expanding   symbol:  JNW_TR_SKY130A/JNWTR_RES8.sym # of pins=3
** sym_path: /home/athanas/pro/aicex/ip/jnw_gr02_sky130a/design/JNW_TR_SKY130A/JNWTR_RES8.sym
** sch_path: /home/athanas/pro/aicex/ip/jnw_gr02_sky130a/design/JNW_TR_SKY130A/JNWTR_RES8.sch
.subckt JNWTR_RES8 N P B
*.iopin N
*.iopin P
*.iopin B
XR1_0 INT_0 N B sky130_fd_pr__res_high_po W=0.36 L=7.36 mult=1 m=1
XR1_1 INT_1 INT_0 B sky130_fd_pr__res_high_po W=0.36 L=7.36 mult=1 m=1
XR1_2 INT_2 INT_1 B sky130_fd_pr__res_high_po W=0.36 L=7.36 mult=1 m=1
XR1_3 INT_3 INT_2 B sky130_fd_pr__res_high_po W=0.36 L=7.36 mult=1 m=1
XR1_4 INT_4 INT_3 B sky130_fd_pr__res_high_po W=0.36 L=7.36 mult=1 m=1
XR1_5 INT_5 INT_4 B sky130_fd_pr__res_high_po W=0.36 L=7.36 mult=1 m=1
XR1_6 INT_6 INT_5 B sky130_fd_pr__res_high_po W=0.36 L=7.36 mult=1 m=1
XR1_7 P INT_6 B sky130_fd_pr__res_high_po W=0.36 L=7.36 mult=1 m=1
.ends


* expanding   symbol:  JNW_TR_SKY130A/JNWTR_RES2.sym # of pins=3
** sym_path: /home/athanas/pro/aicex/ip/jnw_gr02_sky130a/design/JNW_TR_SKY130A/JNWTR_RES2.sym
** sch_path: /home/athanas/pro/aicex/ip/jnw_gr02_sky130a/design/JNW_TR_SKY130A/JNWTR_RES2.sch
.subckt JNWTR_RES2 N P B
*.iopin N
*.iopin P
*.iopin B
XR1_0 INT_0 N B sky130_fd_pr__res_high_po W=0.36 L=7.36 mult=1 m=1
XR1_1 P INT_0 B sky130_fd_pr__res_high_po W=0.36 L=7.36 mult=1 m=1
.ends

.end
