analogicus/jnw_gr02_sky130a/rtl/syntesized_design/pnl/dig.pnl.v

module dig (clk,
    trigger,
    VPWR,
    VGND,
    counter_out);
 input clk;
 input trigger;
 inout VPWR;
 inout VGND;
 output [7:0] counter_out;

 wire _00_;
 wire _01_;
 wire _02_;
 wire _03_;
 wire _04_;
 wire _05_;
 wire _06_;
 wire _07_;
 wire _08_;
 wire _09_;
 wire _10_;
 wire _11_;
 wire _12_;
 wire _13_;
 wire _14_;
 wire _15_;
 wire _16_;
 wire _17_;
 wire _18_;
 wire _19_;
 wire _20_;
 wire _21_;
 wire _22_;
 wire _23_;
 wire _24_;
 wire _25_;
 wire _26_;
 wire _27_;
 wire _28_;
 wire _29_;
 wire _30_;
 wire \counter[0] ;
 wire \counter[1] ;
 wire \counter[2] ;
 wire \counter[3] ;
 wire \counter[4] ;
 wire \counter[5] ;
 wire \counter[6] ;
 wire \counter[7] ;
 wire trigger_prev;
 wire net1;
 wire net2;
 wire net3;
 wire net4;
 wire net5;
 wire net6;
 wire net7;
 wire net8;
 wire net9;
 wire clknet_0_clk;
 wire clknet_1_0__leaf_clk;
 wire clknet_1_1__leaf_clk;
 wire net10;
 wire net11;
 wire net12;
 wire net13;
 wire net14;
 wire net15;
 wire net16;
 wire net17;
 wire net18;
 wire net19;
 wire net20;
 wire net21;
 wire net22;
 wire net23;
 wire net24;
 wire net25;
 wire net26;

 sky130_fd_sc_hd__nand2b_2 _31_ (.A_N(net1),
    .B(trigger_prev),
    .VGND(VGND),
    .VNB(VGND),
    .VPB(VPWR),
    .VPWR(VPWR),
    .Y(_16_));
 sky130_fd_sc_hd__and2b_1 _32_ (.A_N(\counter[0] ),
    .B(_16_),
    .VGND(VGND),
    .VNB(VGND),
    .VPB(VPWR),
    .VPWR(VPWR),
    .X(_00_));
 sky130_fd_sc_hd__a21boi_1 _33_ (.A1(\counter[0] ),
    .A2(\counter[1] ),
    .B1_N(_16_),
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
    .VNB(VGND),
    .VPB(VPWR),
    .VPWR(VPWR));
 sky130_fd_sc_hd__decap_8 FILLER_35_11 (.VGND(VGND),
    .VNB(VGND),
    .VPB(VPWR),
    .VPWR(VPWR));
 sky130_fd_sc_hd__decap_8 FILLER_35_19 (.VGND(VGND),
    .VNB(VGND),
    .VPB(VPWR),
    .VPWR(VPWR));
 sky130_fd_sc_hd__fill_1 FILLER_35_27 (.VGND(VGND),
    .VNB(VGND),
    .VPB(VPWR),
    .VPWR(VPWR));
 sky130_fd_sc_hd__decap_8 FILLER_35_29 (.VGND(VGND),
    .VNB(VGND),
    .VPB(VPWR),
    .VPWR(VPWR));
 sky130_fd_sc_hd__decap_3 FILLER_35_37 (.VGND(VGND),
    .VNB(VGND),
    .VPB(VPWR),
    .VPWR(VPWR));
endmodule
