analogicus/jnw_gr02_sky130a/(commit log)

2025-01-03 Made JNW_GR02_SKY130A
    [JNW_GR02.sch]
2025-02-03 Created a temperature to current converter - visnar
    [JNW_VIS_OTA.sch, JNW_VIS_TI.sch, untitled.sch]
2025-02-03 set up and did a temperature sweep simulation - looks like the T to I is working, around 1.5uA per 25 Degrees Celsius, Reference voltage between 1.18V to 1.23V
2025-02-06 started own design
    [JNW_GBH_TI.sch]
2025-02-11 Semi working version, with python plotting of tempsweep
    [JNW_VIS_OTA.sch, JNW_VIS_TI.sch, TB_JNW_VIS_TI.sch, tran_Sch_tempsweep.csv]
2025-02-11 The Temp to Current works really linearly, the python script creates a nice plot...
    [JNW_VIS_OTA.sch, JNW_VIS_TI.sch, TB_JNW_VIS_TI.sch]
2025-02-13 Circuit prepared for publishing, the summaries are done, the plots are done...
    [JNW_VIS_TI.sch, TB_JNW_VIS_TI.sch, tran_Sch_etc.csv, tran_Sch_mc.csv, tran_Sch_typical.csv]
2025-02-14 Athanas upload
    [OPAMP_AK.sch, TEMP_CURR_AK.sch]
2025-02-14 Made a loop stability analysis, updated the Readme with the results
    [TB_JNW_VIS_TI.sch]
2025-02-20 fixing the OPAMP, reruning simulations
    [JNW_VIS_OTA.sch, JNW_VIS_TI.sch, TB_JNW_VIS_TI.sch]
2025-02-24 created a current to time with comparator - it looks like it works, I need to make everything slower - bigger cap, less current. I have changed the current mirror ratio already.
    [JNW_VIS_ITIME.sch, JNW_VIS_TI.sch, TB_JNW_VIS_ITIME.sch, untitled.sch]
2025-02-24 Done a big update to current consumption, reduced to typical 3.6uA. Created a new module and done simulations on it
    [JNW_VIS_ITIME.sch, JNW_VIS_OTA.sch, JNW_VIS_TI.sch, TB_JNW_VIS_TI.sch, tran_Sch_etc.csv, tran_Sch_mc.csv, tran_Sch_typical.csv]
2025-02-26 voltage to time AK
    [AK_CURR_TIME.sch, TEMP_CURR_AK_SYM.sch]
2025-02-27 different caps
    [JNW_VIS_ITIME.sch]
2025-02-27 new opamp and temp sens AK
    [AK_CURR_TIME.sch, OPAMP_AK.sch, TEMP_CURR_AK.sch]
2025-02-27 Done the simulation for the whole temperagure range in etc - forced me to fix a lot in the modules to make it work
    [JNW_VIS_ITIME.sch, JNW_VIS_OTA.sch, JNW_VIS_TI.sch, TB_JNW_VIS_TI.sch, tran_Sch_etc.csv, tran_Sch_mc.csv, tran_Sch_typical.csv]
2025-03-03 Trying to improve the 3 sigma stuff, playing with different MOS sizes, new python code to make figures...
    [JNW_VIS_OTA.sch, JNW_VIS_TI.sch, TB_JNW_VIS_TI.sch, tran_Sch_etc.csv, tran_Sch_mc.csv, tran_Sch_typical.csv]
2025-03-05 WideSwing current mirror, getting the 3std working slowly
    [JNW_VIS_OTA.sch, JNW_VIS_TI.sch, tran_Sch_etc.csv, tran_Sch_mc.csv, tran_Sch_tempsweep.csv, tran_Sch_typical.csv]
2025-03-07 A lot of playing around with making sure all of the transistors are in active region and in proper gm/id to get the 3std passing... still fails with the current
    [JNW_VIS_OTA.sch, JNW_VIS_TI.sch, TB_JNW_VIS_TI.sch, tran_Sch_etc.csv, tran_Sch_mc.csv, tran_Sch_typical.csv]
2025-03-12 rtl design works as expected, but there are some simulation problems
    [JNW_GR02.sch]
2025-03-13 Finally in 3std, don't touch anymore :) Wrote some deeper explanations
    [JNW_CURRENT.sch, JNW_VIS_OTA.sch, JNW_VIS_OTA_CASC.sch, JNW_VIS_TI.sch, tran_Sch_etc.csv, tran_Sch_mc.csv, tran_Sch_typical.csv]
2025-03-16 tried to make a gate level implementation. does not work
    [JNW_GR02.sch, JNW_GR02_8bMEMORY.sch, JNW_GR02_COUNTER.sch, JNW_GR02_GBH_TST.sch, JNW_VIS_ITIME.sch]
2025-03-19 fixed design. likely problem was that the verilog effected its own signals
    [JNW_GR02.sch]
2025-03-20 tried adding clock divider for CAP_RESET. error with simulation
    [JNW_GR02.sch]
2025-03-20 made a working version. using 2 d-latches to make sure that the analog part has time to read the signal.
    [JNW_GR02.sch, JNW_VIS_ITIME.sch]
2025-03-25 Improved the OTA, updated the simulations, starting with layout
    [JNW_GR02_VIS.sch, JNW_VIS_INV.sch, JNW_VIS_ITIME.sch, JNW_VIS_OTA.sch, tran_Sch_etc.csv, tran_Sch_mc.csv, tran_Sch_typical.csv]
2025-04-05 managed to compile rtl using openlane2. it should be compatible with the aicex framework
    [dig__max_ff_n40C_1v95.sdf, dig__max_ss_100C_1v60.sdf, dig__max_tt_025C_1v80.sdf, dig__min_ff_n40C_1v95.sdf, dig__min_ss_100C_1v60.sdf, dig__min_tt_025C_1v80.sdf, dig__nom_ff_n40C_1v95.sdf, dig__nom_ss_100C_1v60.sdf]
2025-04-08 just some playing around, going to layout
    [JNW_GR02_VIS.sch, JNW_VIS_ITIME.sch]
2025-04-10 made temp to frequency
    [JNW_GR02_VIS.sch, JNW_VIS_ITIME.sch, JNW_VIS_OTA.sch]
2025-04-10 started integrating syntesized rtl int simulation
    [JNW_GR02_dig.sch, dig.sch, untitled.sch]
2025-04-10 Using a current starved VCO to get the tempreading out
    [JNW_VIS_ITIME.sch]
2025-04-10 removed use of one component because of error. still problems with runing simulation
    [JNW_GR02_dig.sch, JNW_VIS_ITIME.sch, dig__max_ff_n40C_1v95.sdf, dig__max_ss_100C_1v60.sdf, dig__max_tt_025C_1v80.sdf, dig__min_ff_n40C_1v95.sdf, dig__min_ss_100C_1v60.sdf, dig__min_tt_025C_1v80.sdf]
2025-04-11 Layout for OTA and JNW_VIS_TI done, make cdl and lvs pass, but lpe is failing...
    [JNW_VIS_TI.sch, untitled.sch]
2025-04-12 made design for ITIME. had to change some ports for JNW_VIS_ITIME because of problems with RST
    [JNW_VIS_ITIME.sch]
2025-04-12 got lvs to pass localy on pc
    [JNW_VIS_ITIME.sch]
2025-04-13 tried to fix lvs erroes. no difference
    [JNW_VIS_TI.sch]
2025-04-13 changed physical dimentions of digital logic to fit better with rest.
    [JNW_GR02.sch, dig__max_ff_n40C_1v95.sdf, dig__max_ss_100C_1v60.sdf, dig__max_tt_025C_1v80.sdf, dig__min_ff_n40C_1v95.sdf, dig__min_ss_100C_1v60.sdf, dig__min_tt_025C_1v80.sdf, dig__nom_ff_n40C_1v95.sdf]
2025-04-13 Tried to fix the layout, it phantomly connects to GND... don't know where, blame the inverters that have a mismatch as well
    [JNW_GR02_VIS.sch, untitled.sch]
2025-04-13 split analog and digital
    [JNW_GR02_temperature.sch]
2025-04-13 cleaned up dead schematics
    [JNW_GBH_TI.sch, JNW_GR02_8bMEMORY.sch, JNW_GR02_COUNTER.sch]
2025-04-13 fixed tran.spi to be able to simulate schematic
2025-04-24 Fixed the LVS fro the JNW_GR02_VIS, NWELL and DWELL
    [tran_Sch_typical.csv]
2025-04-27 VIS_OTA LPE works
    [JNW_VIS_OTA.sch, PCH_12C1F2_4.sch, PCH_12C5F0_4.sch]
2025-04-28 with changing the sky130A_setup, the lpe is finally working
    [JNW_VIS_OTA.sch]
2025-04-28 Remade the simulations with the layout parameters, updated the readme with new figures and results
    [JNW_VIS_OTA.sch, JNW_VIS_TI.sch, tran_Lay_etc.csv, tran_Lay_mc.csv, tran_Lay_typical.csv]
2025-04-30 After report report push
    [tran_Lay_mc.csv]
